ChanchalSakardeQH/StringArt_Nema17_A4899_OLED_SG90/CircuitDiagram/ComponetsUsed/A4988 42 Stepper Motor Driver Expansion Board.jpg

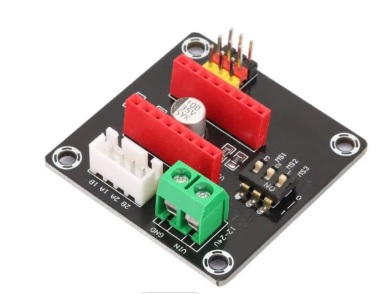
CircuitDiagram/ComponetsUsed/A4988 42 Stepper Motor Driver Expansion Board.jpg
