ChanchalSakardeQH/StringArt_Nema17_A4899_OLED_SG90/CircuitDiagram/ComponetsUsed/A4988 Stepper Motor Driver.jpg

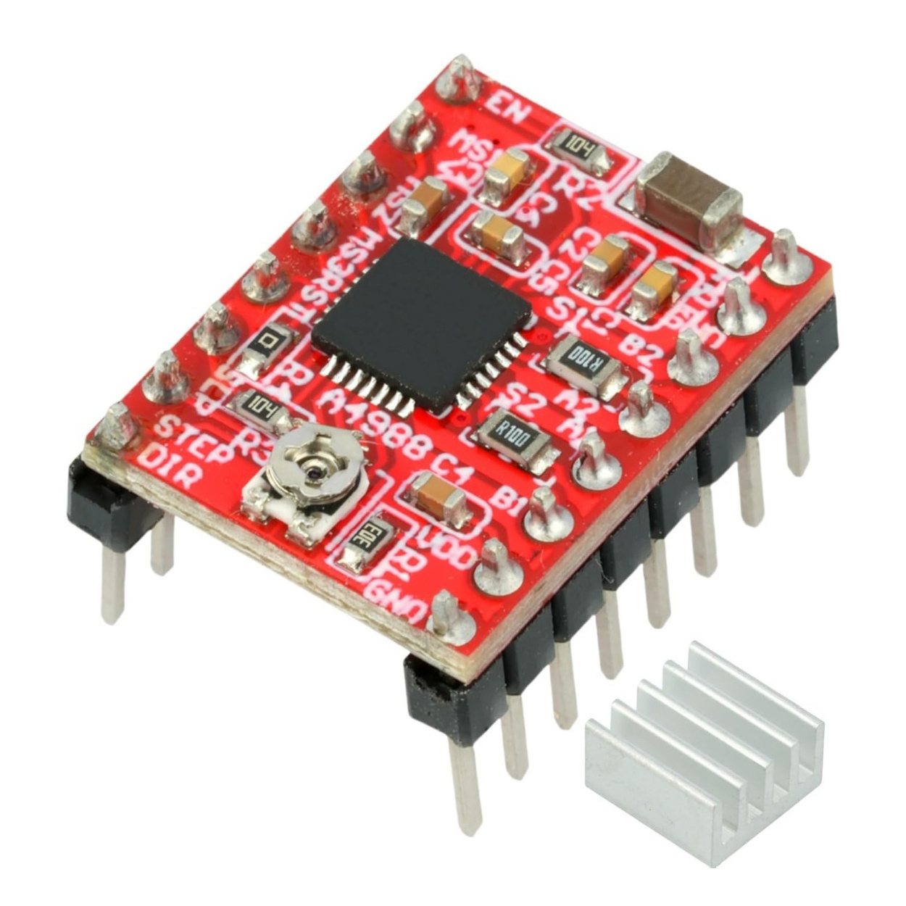
CircuitDiagram/ComponetsUsed/A4988 Stepper Motor Driver.jpg
