ChanchalSakardeQH/StringArt_Nema17_A4899_OLED_SG90/CircuitDiagram/ComponetsUsed/esp32_30_pin_devkit.jpg

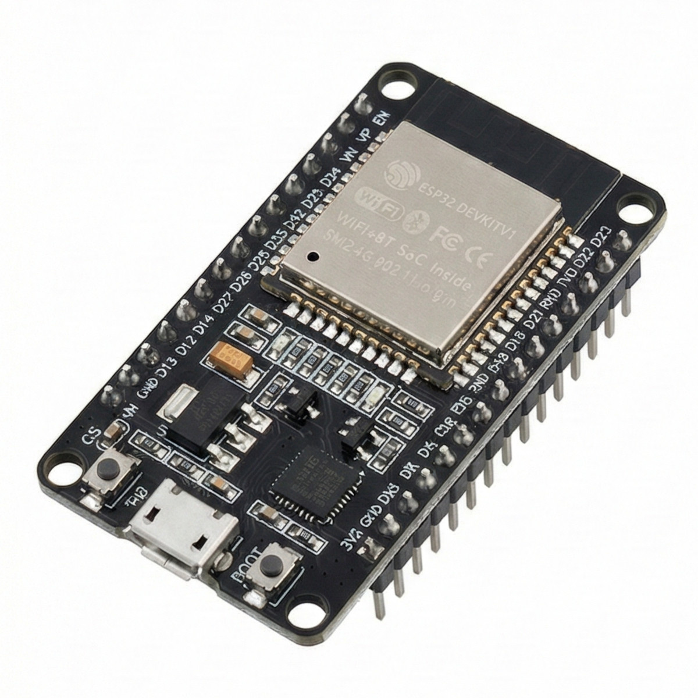
CircuitDiagram/ComponetsUsed/esp32_30_pin_devkit.jpg
