ChanchalSakardeQH/StringArt_Nema17_A4899_OLED_SG90/CircuitDiagram/ComponetsUsed/limit-switch.jpg

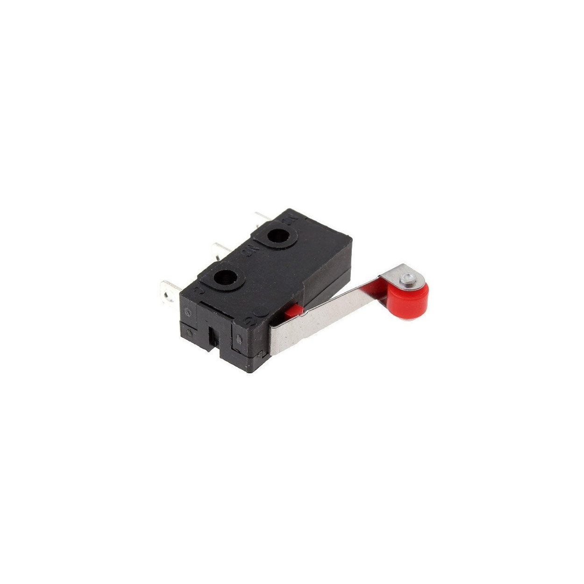
CircuitDiagram/ComponetsUsed/limit-switch.jpg
