ChanchalSakardeQH/StringArt_Nema17_A4899_OLED_SG90/CircuitDiagram/ComponetsUsed/nema_17_stepper_motor_4.2kg.jpg

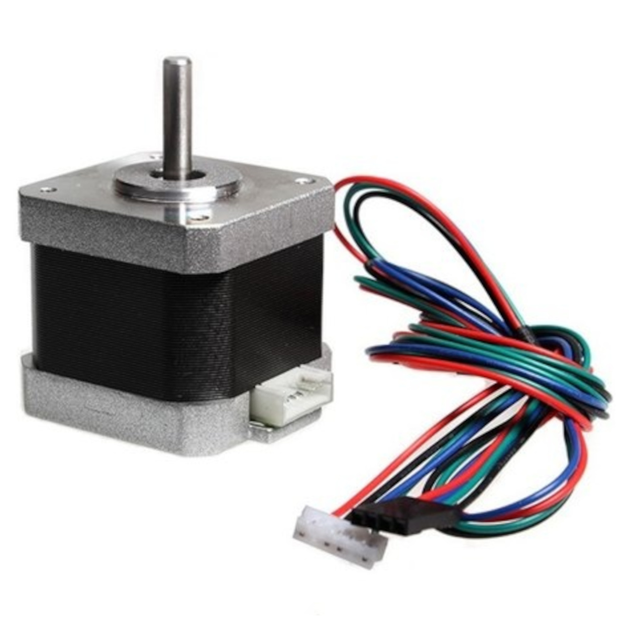
CircuitDiagram/ComponetsUsed/nema_17_stepper_motor_4.2kg.jpg
