ChanchalSakardeQH/StringArt_Nema17_A4899_OLED_SG90/CircuitDiagram/ComponetsUsed/SG90_90degree_ServoMotor.jpg

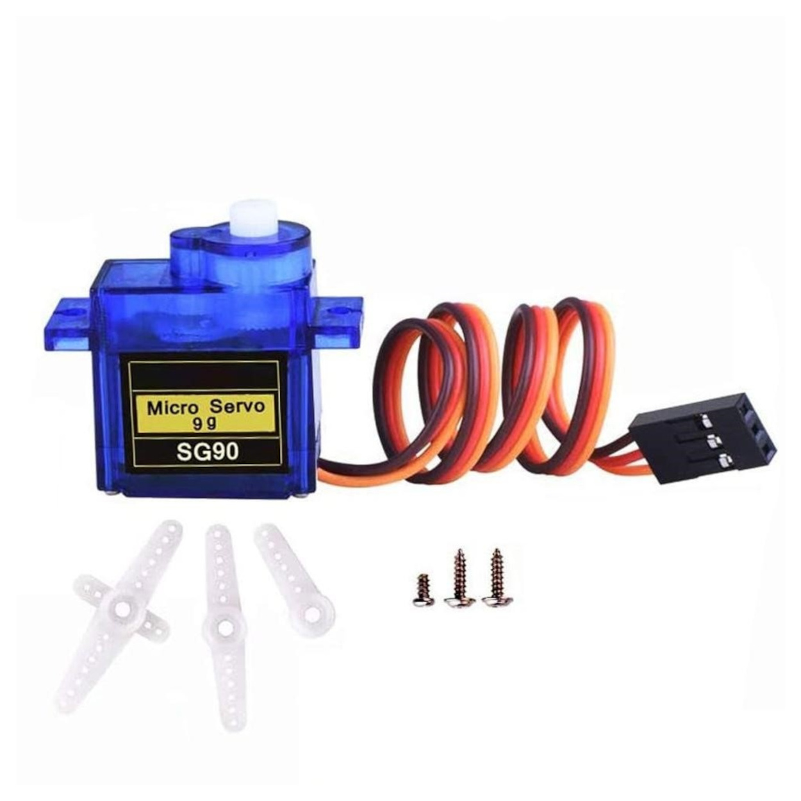
CircuitDiagram/ComponetsUsed/SG90_90degree_ServoMotor.jpg
