ChanchalSakardeQH/StringArt_Nema17_A4899_OLED_SG90/CircuitDiagram/greeting_card_sample.png

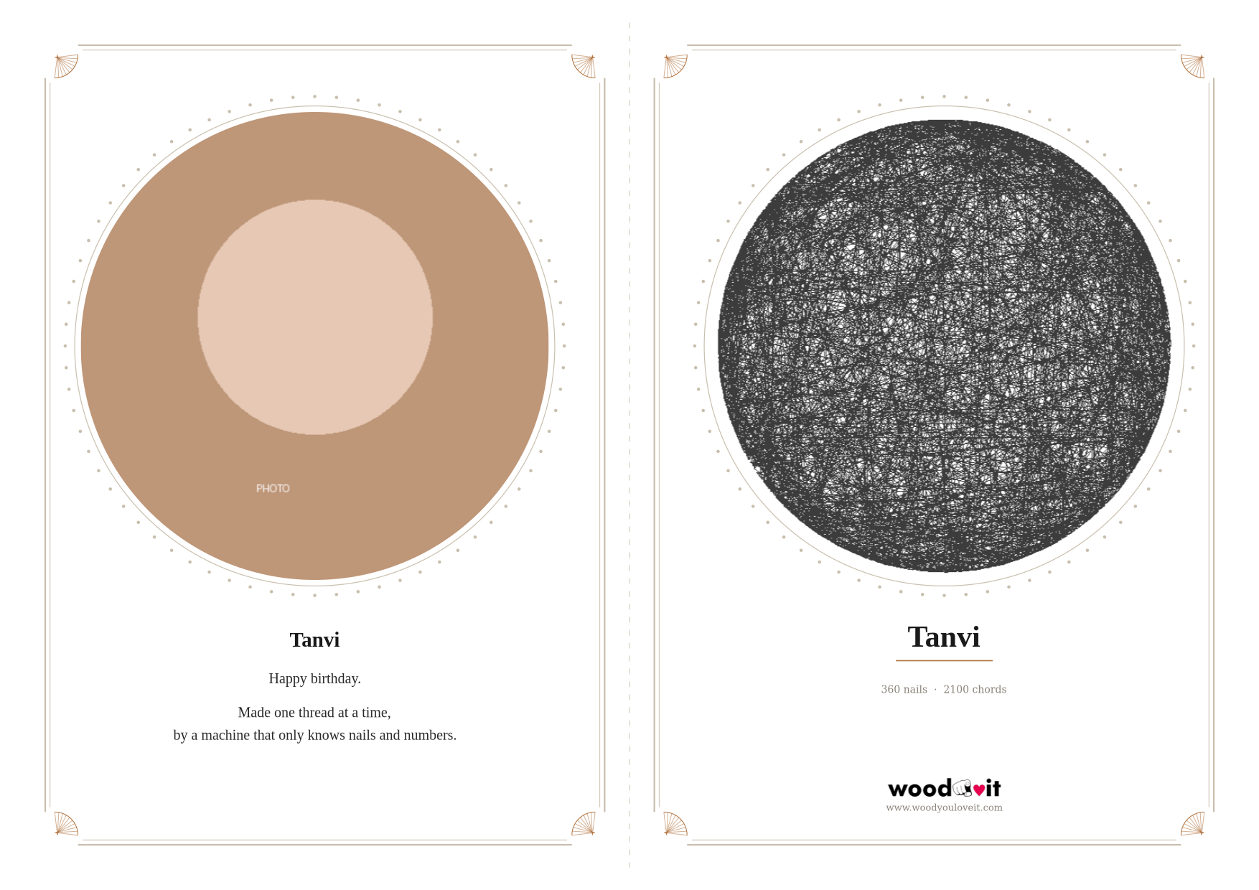
CircuitDiagram/greeting_card_sample.png
