ChanchalSakardeQH/StringArt_Nema17_A4899_OLED_SG90/CircuitDiagram/perfboard_layout.png

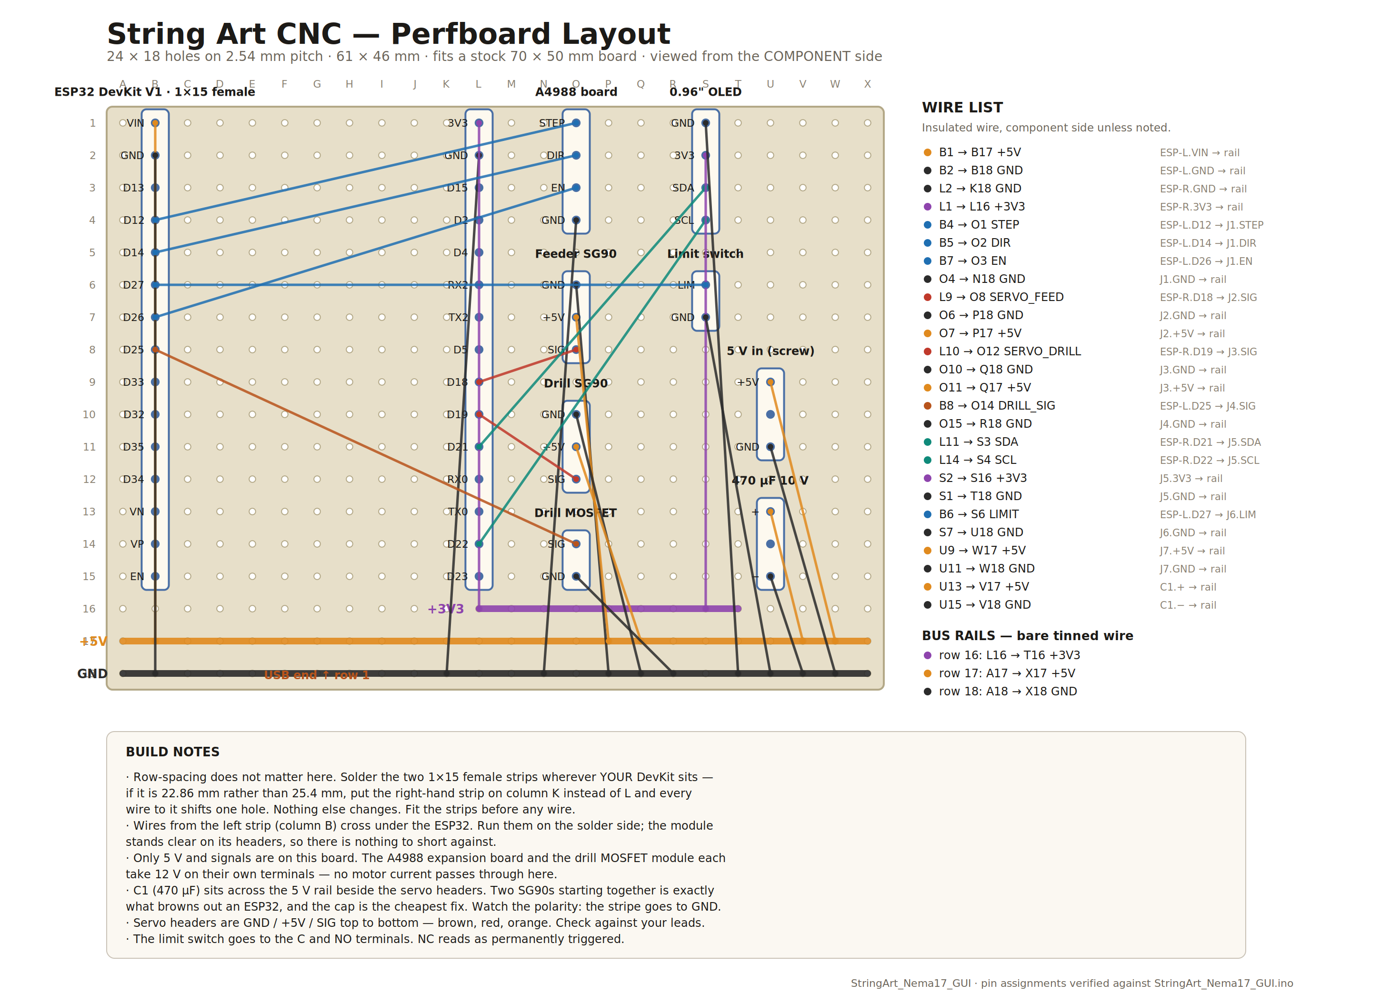
CircuitDiagram/perfboard_layout.png
