ChanchalSakardeQH/StringArt_Nema17_A4899_OLED_SG90/CircuitDiagram/woodyouloveit.com.png

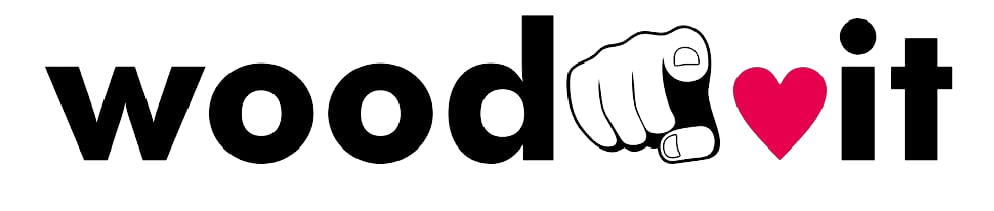
CircuitDiagram/woodyouloveit.com.png
