ChanchalSakardeQH/StringArt_Nema17_A4899_OLED_SG90/(notices)

Notices in the files:
StringArt_Nema17_A4899_OLED_SG90/oled_display.h:
String Art CNC is free software: you can redistribute it and/or modify
it under the terms of the GNU General Public License as published by the Free
StringArt_Nema17_A4899_OLED_SG90/StringArt_Nema17_A4899_OLED_SG90.ino:
under the terms of the GNU General Public License as published by the Free
